uastw-embsys/dps368_breakout_board/panel/production/bom.csv

Designator | Footprint | Quantity | Value | LCSC Part #
C1, C10, C11, C12, C2, C3, C4, C5, C6, C7, C8, C9 | 0603 | 12 | 100n
J1, J2, J3, J4, J5, J6 | DIP-8_W10.16mm_LongPads | 6 | Conn_02x04_Counter_Clockwise
MOUSE-BITE-2.54MM-4.66MM_12, MOUSE-BITE-2.54MM-4.66MM_11, MOUSE-BITE-2.54MM-4.66MM_10, MOUSE-BITE-2.54MM-4.66MM_9, MOUSE-BITE-2.54MM-4.66MM_8, MOUSE-BITE-2.54MM-4.66MM_7, MOUSE-BITE-2.54MM-4.66MM_6, MOUSE-BITE-2.54MM-4.66MM_5, MOUSE-BITE-2.54MM-4.66MM_4, MOUSE-BITE-2.54MM-4.66MM_3, MOUSE-BITE-2.54MM-4.66MM_2, MOUSE-BITE-2.54MM-4.66MM | mouse-bite-2.54mm-4.66mm | 12 | VAL**
U1, U2, U3, U4, U5, U6 | LGA8S145X65P2X4_200X250X110-V | 6 | DPS368
