uastw-embsys/dps368_breakout_board/kicad/dps368-microbus-breakout/_restore_backup_2026-09-18T08-40-17-081/dps368-microbus-breakout.kicad_pcb

## KiCad design kicad/dps368-microbus-breakout/_restore_backup_2026-09-18T08-40-17-081/dps368-microbus-breakout.kicad_pcb (2026-10-13)

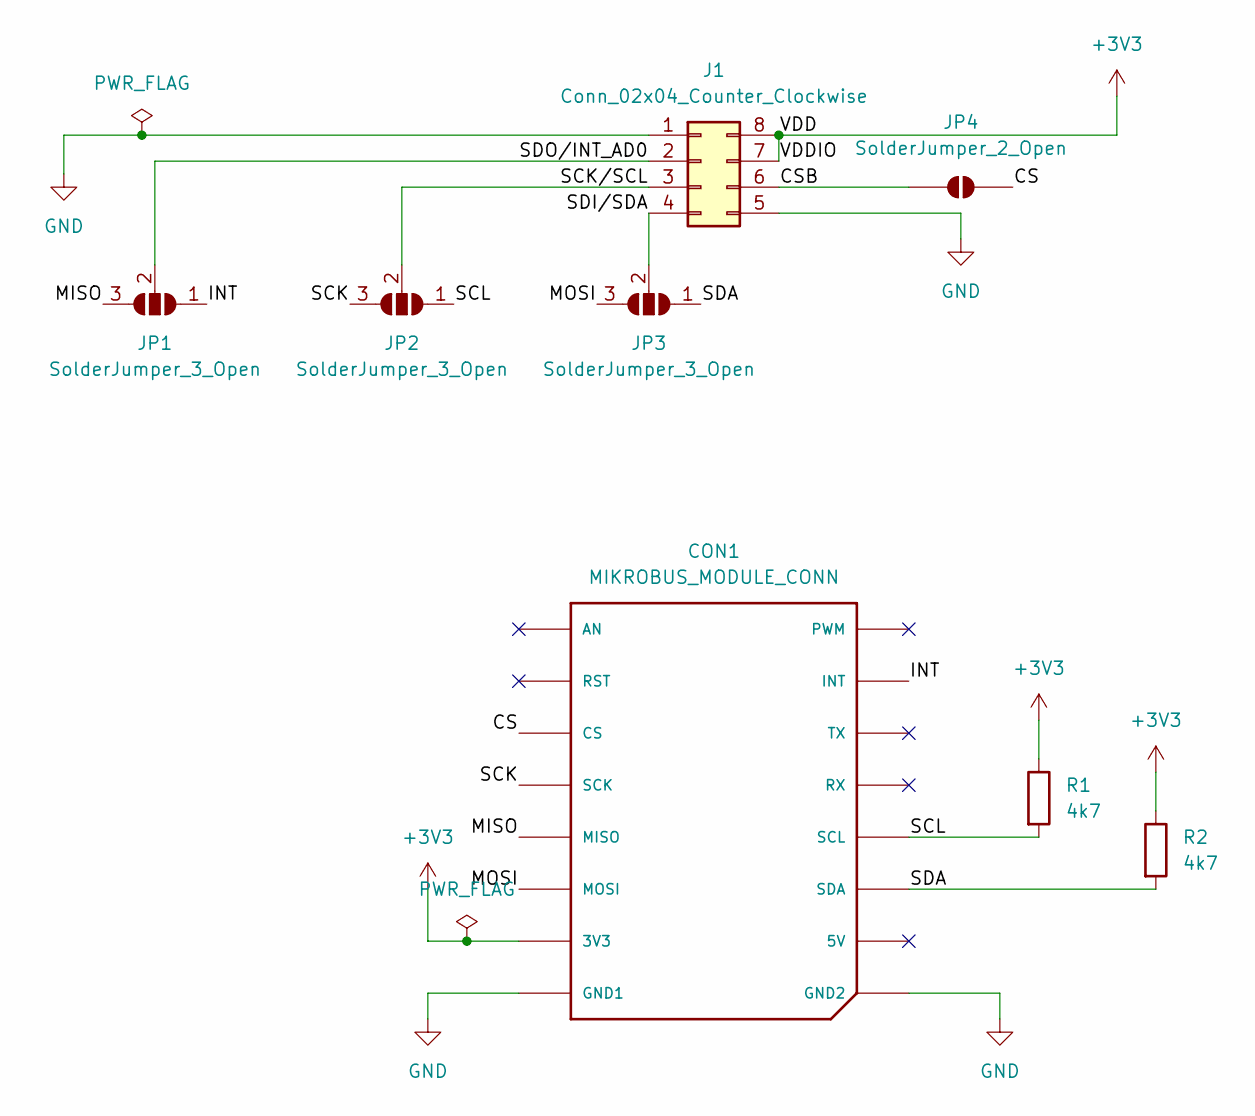
[picture p4: schematic dps368-microbus-breakout.kicad_sch]

Parts:
CON1: MIKROBUS_MODULE_CONN
J1: Conn_02x04_Counter_Clockwise; DIP-8_W10.16mm_LongPads
JP1, JP2, JP3: SolderJumper_3_Open; SolderJumper-3_P1.3mm_Open_Pad1.0x1.5mm
JP4: SolderJumper_2_Open; SolderJumper-2_P1.3mm_Open_Pad1.0x1.5mm
R1, R2: 4k7; R_0603_1608Metric

Connections:
+3V3: CON1.P7 (3V3), J1.7, J1.8, R1.1, R2.1
/CS: CON1.P3 (CS), JP4.2 (B)
/CSB: J1.6, JP4.1 (A)
/INT: CON1.P15 (INT), JP1.1 (A)
/MISO: CON1.P5 (MISO), JP1.3 (B)
/MOSI: CON1.P6 (MOSI), JP3.3 (B)
/SCK: CON1.P4 (SCK), JP2.3 (B)
/SCK/SCL: J1.3, JP2.2 (C)
/SCL: CON1.P12 (SCL), JP2.1 (A), R1.2
/SDA: CON1.P11 (SDA), JP3.1 (A), R2.2
/SDI/SDA: J1.4, JP3.2 (C)
/SDO/INT_AD0: J1.2, JP1.2 (C)
GND: CON1.P8 (GND1), CON1.P9 (GND2), J1.1, J1.5

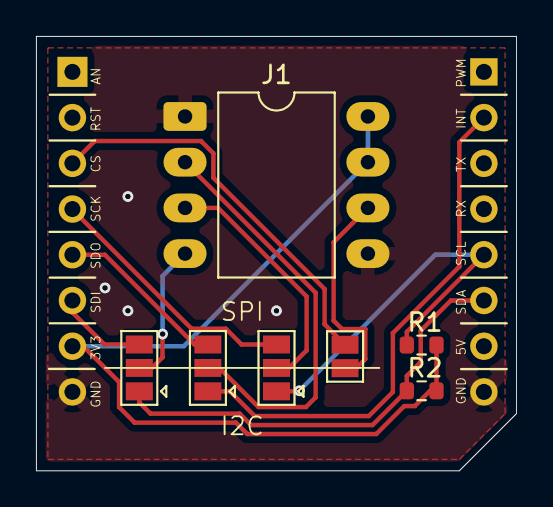
[picture p5: board dps368-microbus-breakout.kicad_pcb from above]

Board: 2 copper layers, 26.7 x 24.1 mm, 8 parts (0 on the bottom side), 13 nets.
