uastw-embsys/dps368_breakout_board/kicad/dps368_breakout_board/dps368_breakout_board.kicad_pcb

## KiCad design kicad/dps368_breakout_board/dps368_breakout_board.kicad_pcb (2026-09-15)

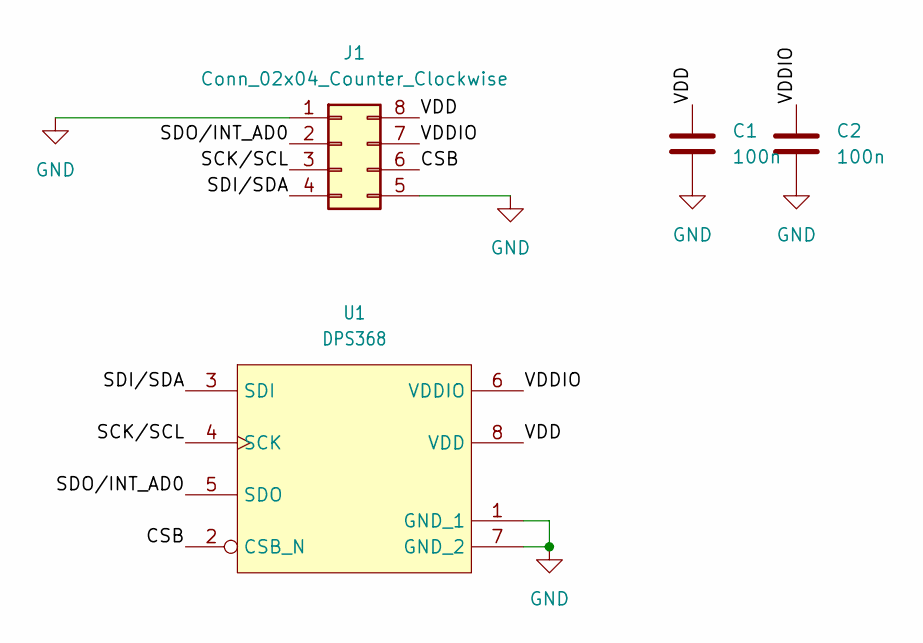
[picture p6: schematic dps368_breakout_board.kicad_sch]

Parts:
C1, C2: 100n; C_0603_1608Metric
J1: Conn_02x04_Counter_Clockwise; DIP-8_W10.16mm_LongPads
U1: DPS368; LGA8S145X65P2X4_200X250X110-V

Connections:
/CSB: J1.6, U1.2 (CSB_N)
/SCK/SCL: J1.3, U1.4 (SCK)
/SDI/SDA: J1.4, U1.3 (SDI)
/SDO/INT_AD0: J1.2, U1.5 (SDO)
/VDD: C1.1, J1.8, U1.8 (VDD)
/VDDIO: C2.1, J1.7, U1.6 (VDDIO)
GND: C1.2, C2.2, J1.1, J1.5, U1.1 (GND_1), U1.7 (GND_2)

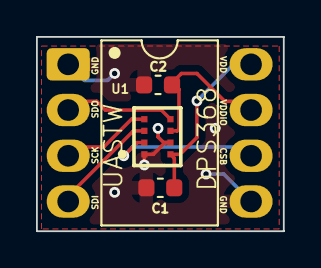
[picture p7: board dps368_breakout_board.kicad_pcb from above]

Board: 2 copper layers, 13.7 x 10.8 mm, 4 parts (0 on the bottom side), 7 nets.
